ubcspin/CuddleBits/README.md

CuddleBits are simple robots designed to study affective touch. This repository contains instructions on how to build your own CuddleBits, as well as modify the starter templates provided. Two main kinds of CuddleBits are contained here: RibBits and FlexiBits.

Check out [www.cs.ubc.ca/labs/spin/cuddlebits](http://www.cs.ubc.ca/labs/spin/cuddlebits) for the project page.
