ubcspin/CuddleBits/ribbit/full.SLDASM

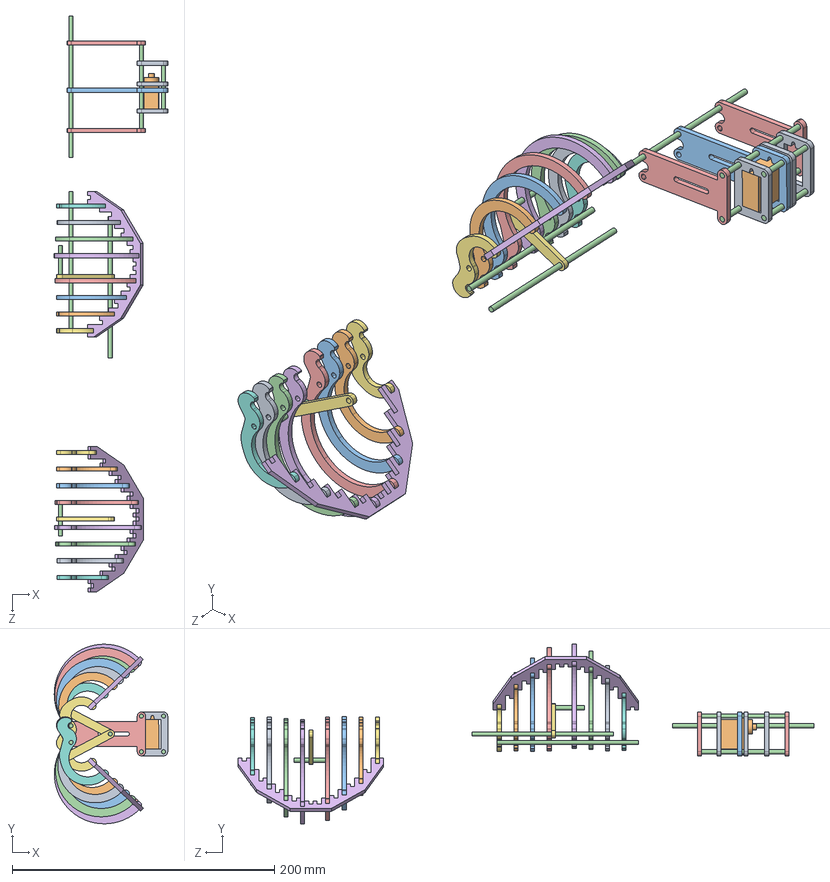
[picture p1: CAD file, 2016-09-14, last stored version]
ribbit/full.SLDASM
86.6 x 137.0 x 439.2 mm
servo_brackt x 3
servo
servo_strut_bracket
pin x 9
strut_support x 2
rib_holder x 2
rib00 x 2
rib01 x 2
rib03 x 2
rib02 x 2
rib04 x 2
rib05 x 2
rib06 x 2
rib07 x 2
bar x 2
