ubcspin/CuddleBits/ribbit/frame.SLDASM

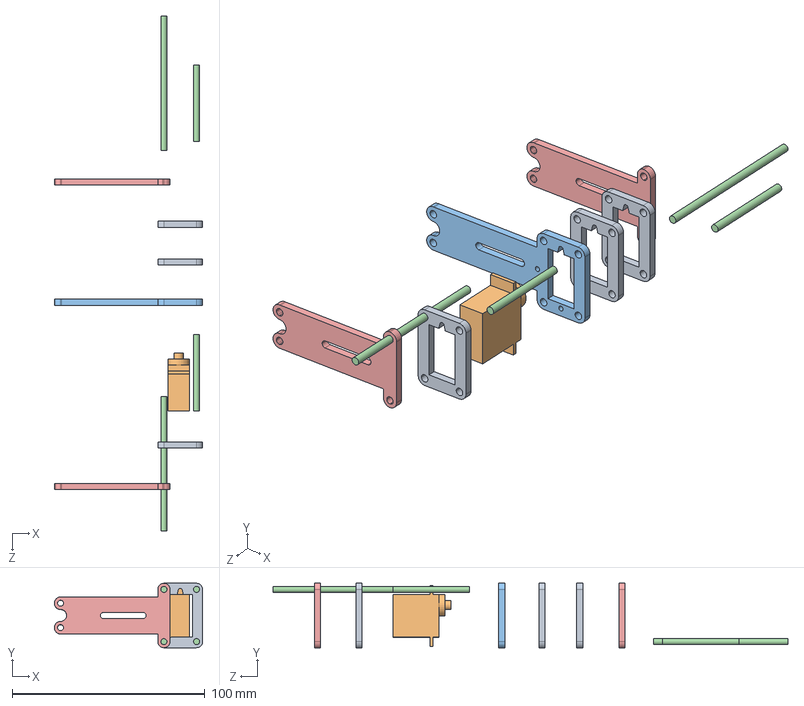
[picture p2: CAD file, 2016-09-14, last stored version]
ribbit/frame.SLDASM
77.0 x 33.5 x 267.4 mm
servo_brackt x 3
servo
servo_strut_bracket
pin x 4
strut_support x 2
