ubcspin/CuddleBits/ribbit/ribs.SLDASM

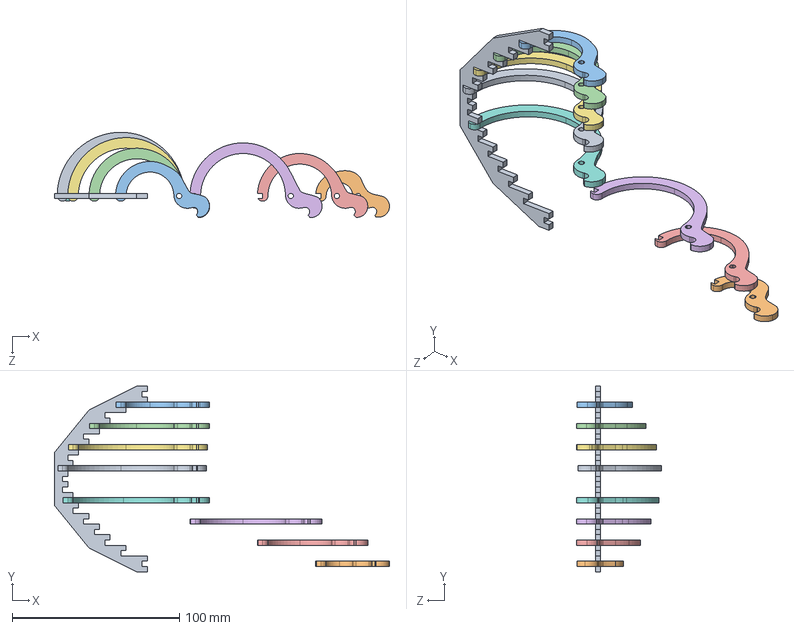
[picture p3: CAD file, 2016-09-14, last stored version]
ribbit/ribs.SLDASM
200.5 x 111.1 x 51.1 mm
rib_holder
rib00
rib01
rib03
rib02
rib04
rib05
rib06
rib07
