ubcspin/CuddleBits/ribbit/servo.SLDPRT

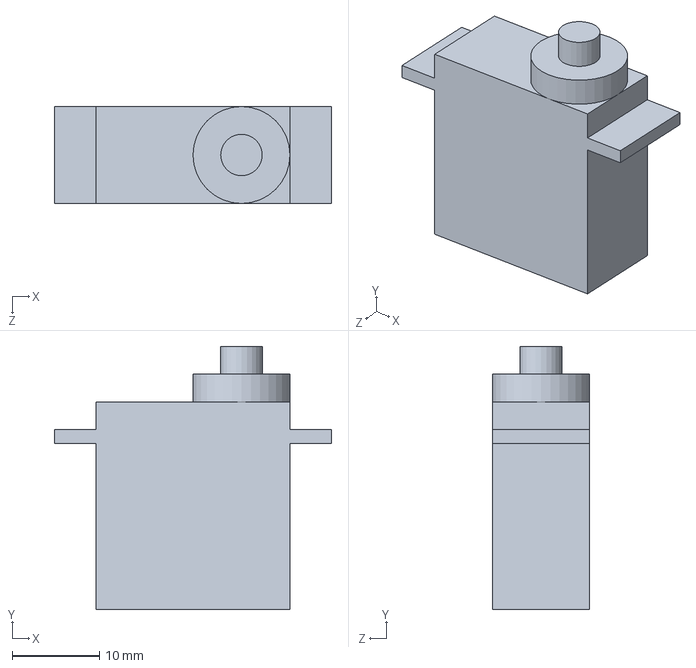
[picture p4: CAD file, 2016-09-14, last stored version]
ribbit/servo.SLDPRT
31.8 x 30.2 x 11.1 mm
