ubcspin/CuddleBits/ribbit/pin_end_flat.sldprt

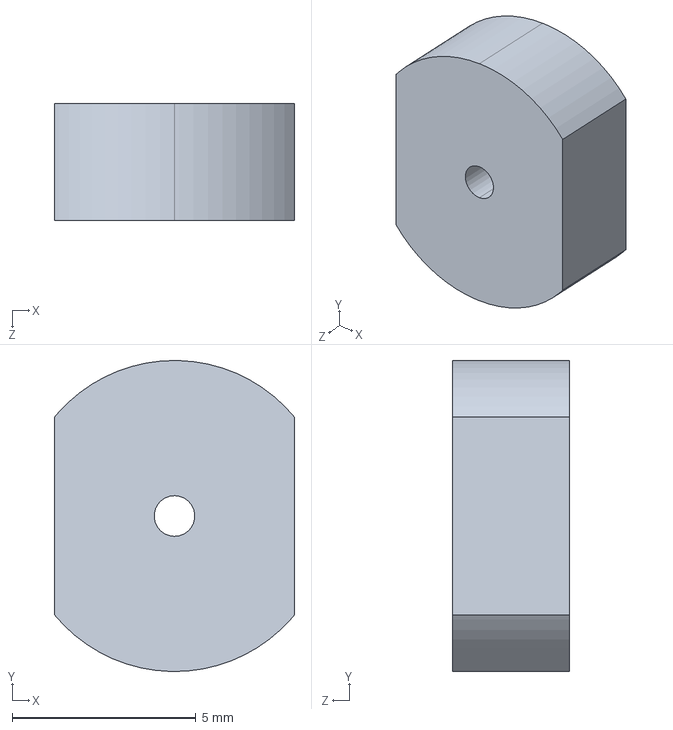
[picture p5: CAD file, 2016-09-14, last stored version]
ribbit/pin_end_flat.sldprt
6.54 x 8.47 x 3.17 mm
