ubcspin/CuddleBits/ribbit/rib07.sldprt

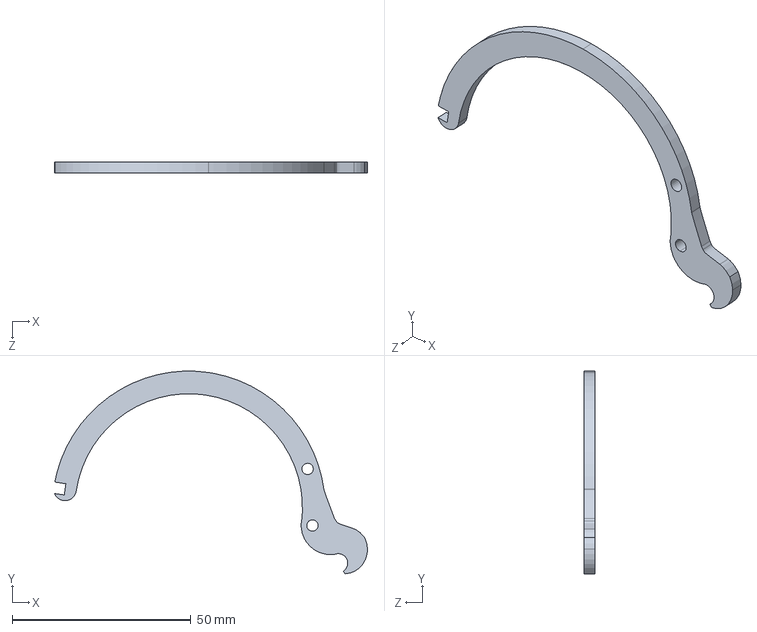
[picture p6: CAD file, 2016-09-14, last stored version]
ribbit/rib07.sldprt
87.4 x 56.6 x 3.17 mm
