ubcspin/CuddleBits/ribbit/rib08.sldprt

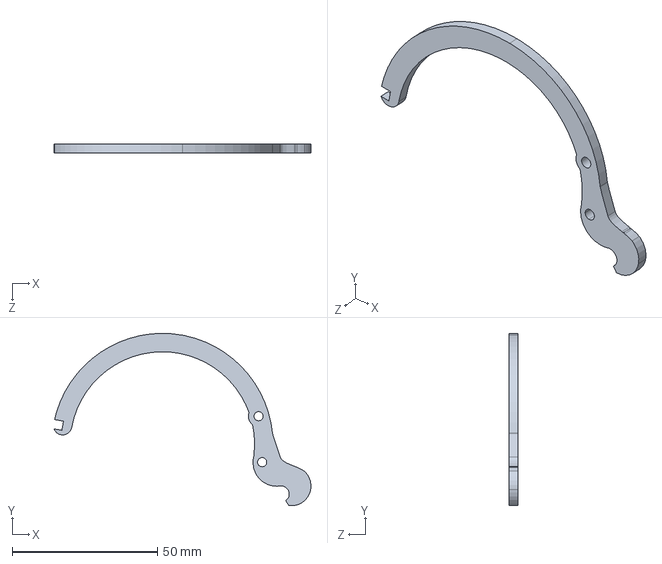
[picture p7: CAD file, 2016-09-14, last stored version]
ribbit/rib08.sldprt
88.5 x 59.3 x 3.17 mm
