ubcspin/CuddleBits/ribbit/rib02.sldprt

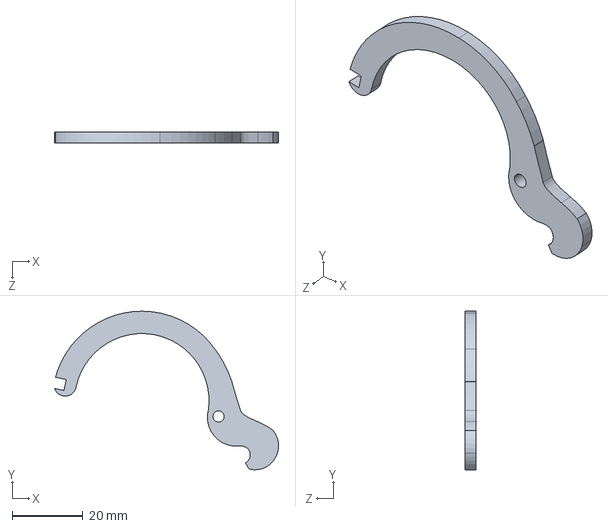
[picture p8: CAD file, 2016-09-14, last stored version]
ribbit/rib02.sldprt
63.5 x 45.0 x 3.17 mm
