ubcspin/CuddleBits/ribbit/strut_support.sldprt

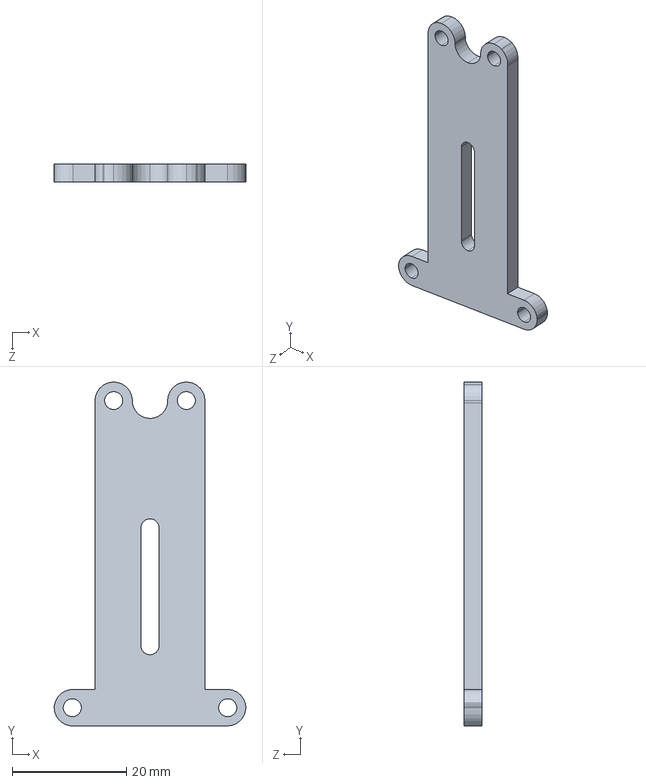
[picture p9: CAD file, 2016-09-14, last stored version]
ribbit/strut_support.sldprt
33.5 x 60.1 x 3.17 mm
