ubcspin/CuddleBits/ribbit/pin_end.sldprt

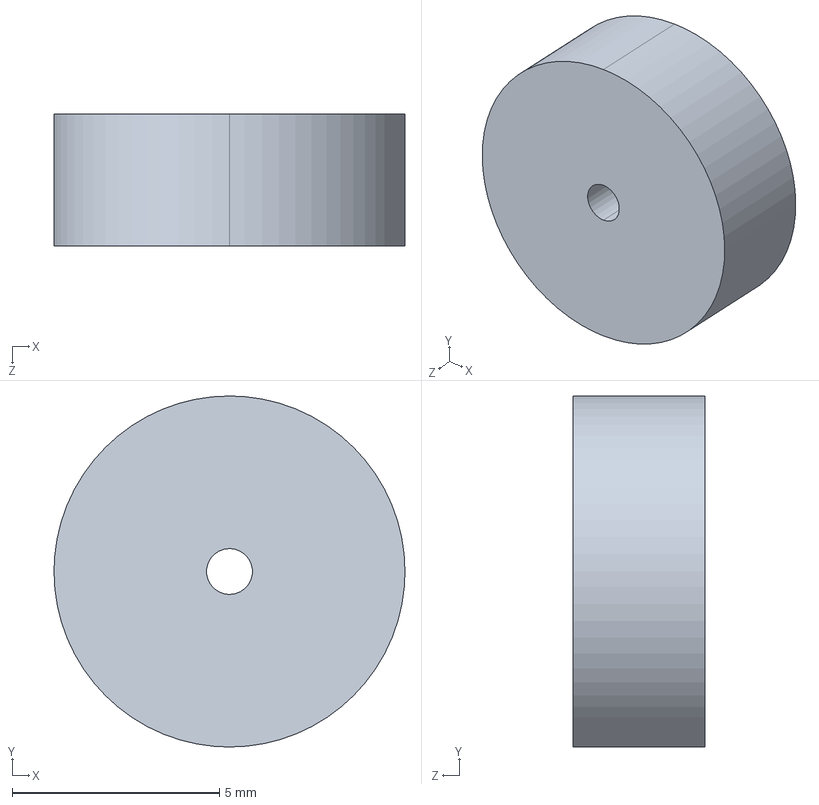
[picture p10: CAD file, 2016-09-14, last stored version]
ribbit/pin_end.sldprt
8.47 x 8.47 x 3.17 mm
