ubcspin/CuddleBits/ribbit/bar.sldprt

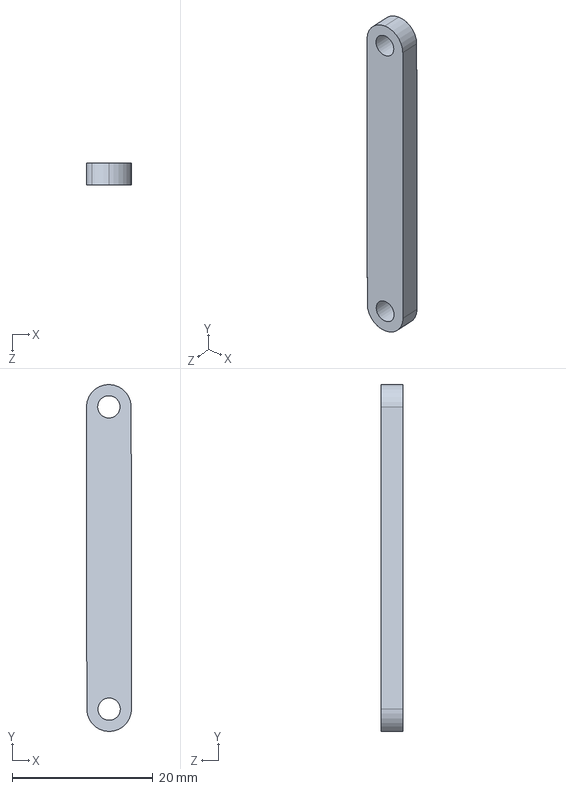
[picture p11: CAD file, 2016-09-14, last stored version]
ribbit/bar.sldprt
6.40 x 49.3 x 3.17 mm
