ubcspin/CuddleBits/ribbit/rib06.sldprt

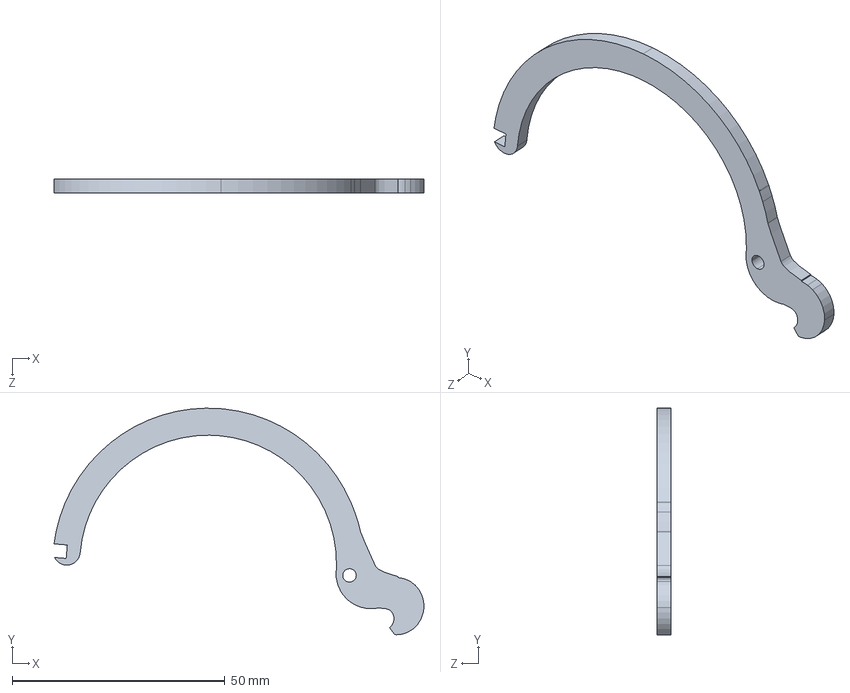
[picture p12: CAD file, 2016-09-14, last stored version]
ribbit/rib06.sldprt
86.9 x 53.3 x 3.17 mm
