ubcspin/CuddleBits/ribbit/rib_holder.sldprt

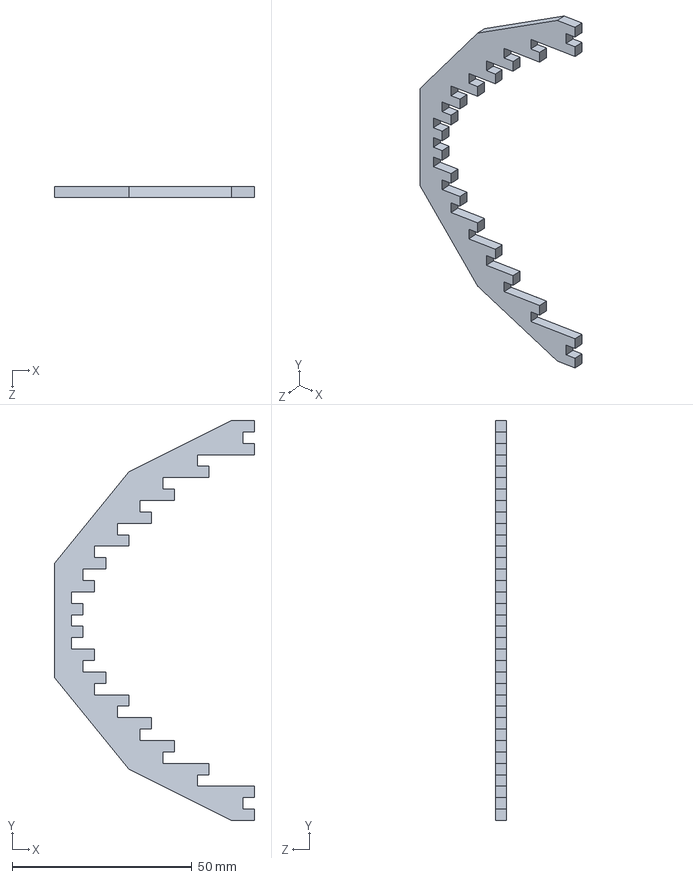
[picture p13: CAD file, 2016-09-14, last stored version]
ribbit/rib_holder.sldprt
55.6 x 111.1 x 3.17 mm
