ubcspin/CuddleBits/ribbit/servo_strut_bracket.sldprt

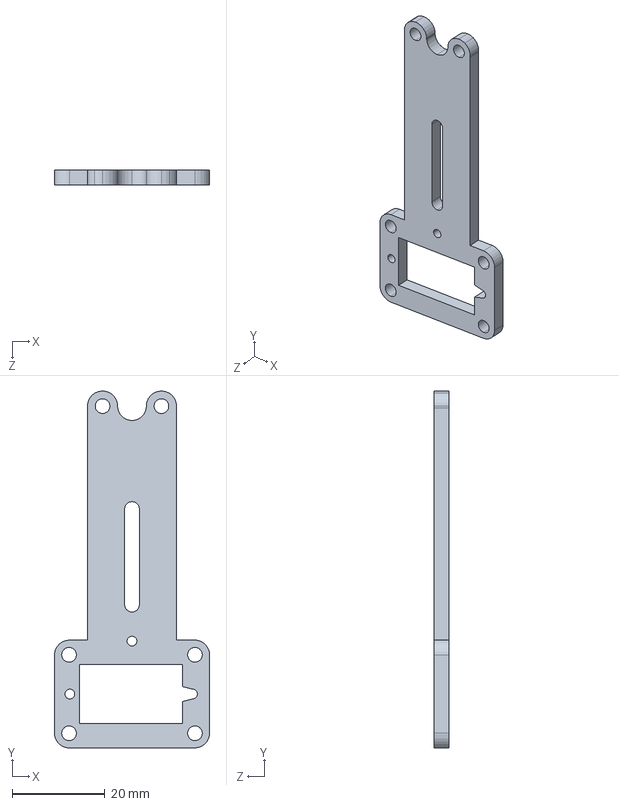
[picture p14: CAD file, 2016-09-14, last stored version]
ribbit/servo_strut_bracket.sldprt
33.5 x 77.0 x 3.17 mm
