ubcspin/CuddleBits/ribbit/rib05.sldprt

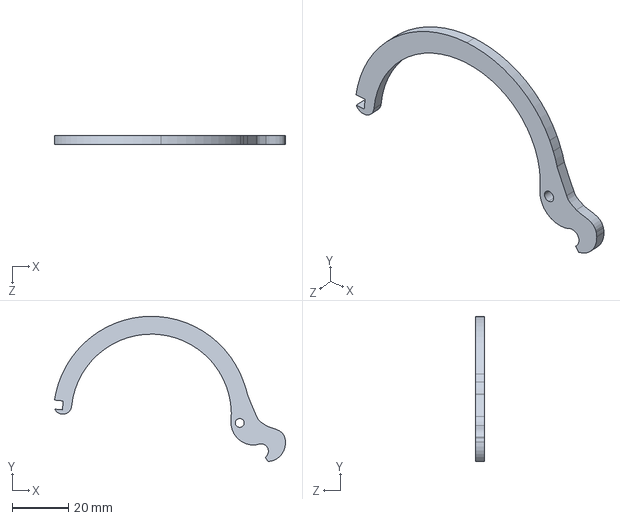
[picture p15: CAD file, 2016-09-14, last stored version]
ribbit/rib05.sldprt
82.5 x 51.9 x 3.17 mm
