ubcspin/CuddleBits/ribbit/rib01.sldprt

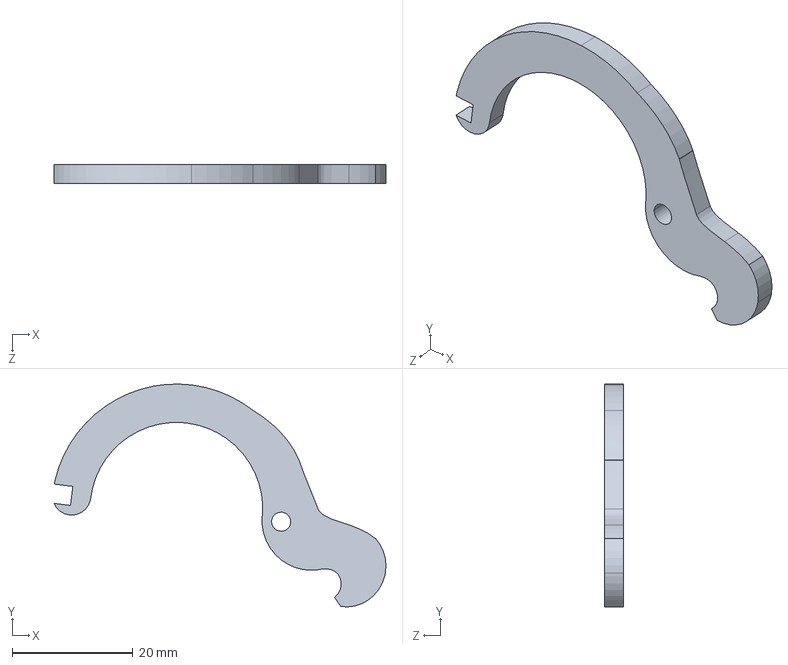
[picture p16: CAD file, 2016-09-14, last stored version]
ribbit/rib01.sldprt
54.9 x 36.9 x 3.17 mm
