ubcspin/CuddleBits/ribbit/pin.SLDPRT

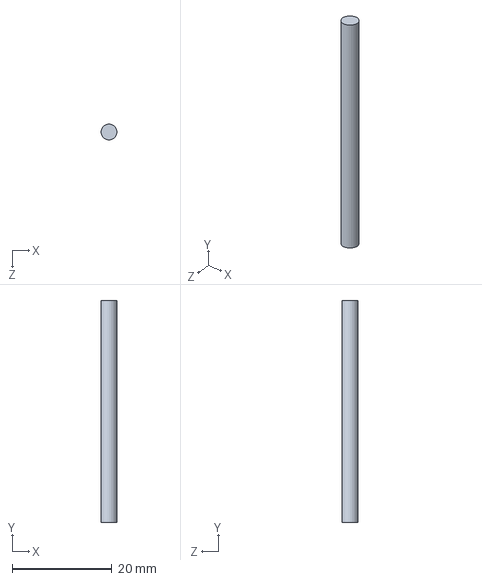
[picture p17: CAD file, 2016-09-14, last stored version]
ribbit/pin.SLDPRT
3.17 x 44.5 x 3.17 mm
