ubcspin/CuddleBits/ribbit/rib04.sldprt

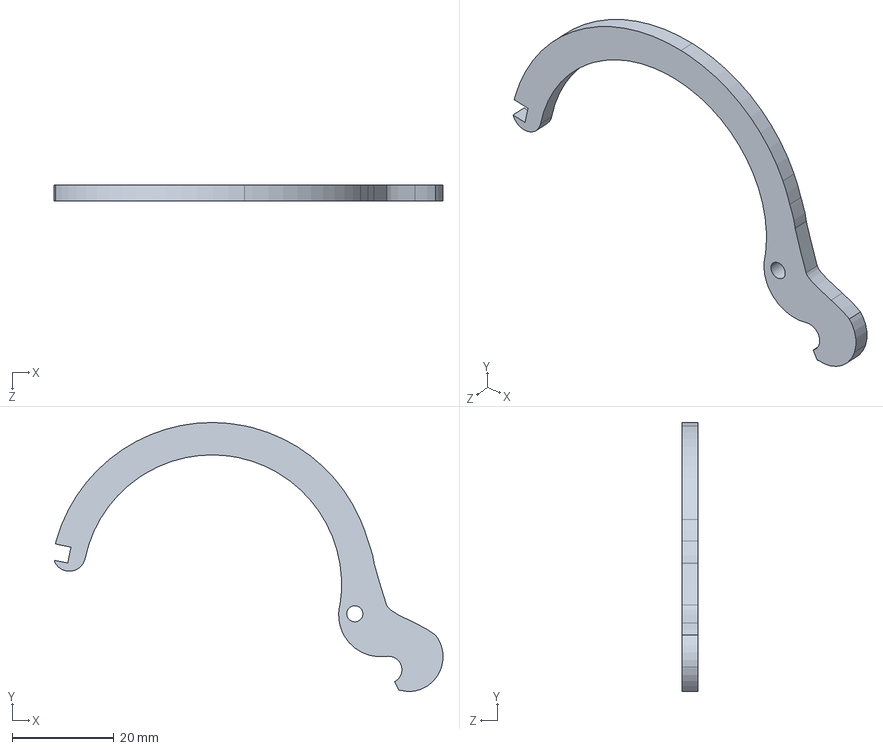
[picture p18: CAD file, 2016-09-14, last stored version]
ribbit/rib04.sldprt
76.3 x 52.8 x 3.17 mm
