ubcspin/CuddleBits/ribbit/orig_from_ai.dxf

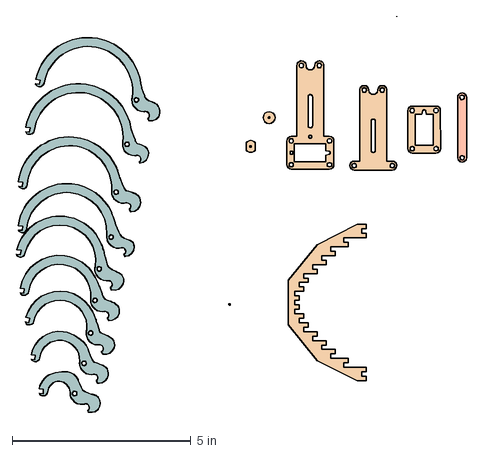
[picture p19: CAD file, 2016-09-14, last stored version]
ribbit/orig_from_ai.dxf
12.6 x 11.1 in
