ubcspin/CuddleBits/ribbit/servo_brackt.sldprt

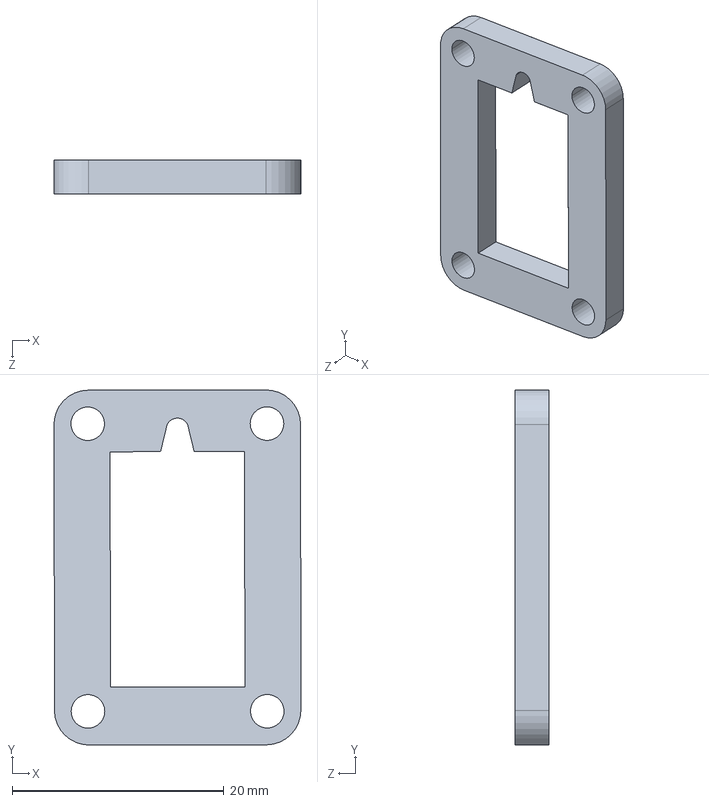
[picture p20: CAD file, 2016-09-14, last stored version]
ribbit/servo_brackt.sldprt
23.3 x 33.5 x 3.17 mm
