ubcspin/CuddleBits/ribbit/rib00.sldprt

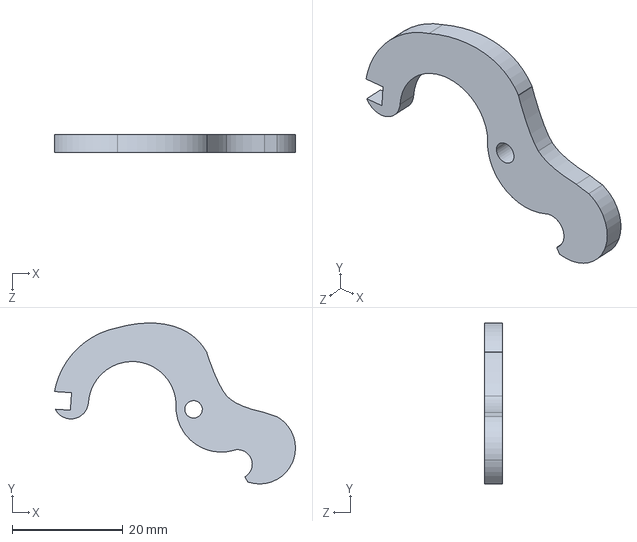
[picture p21: CAD file, 2016-09-14, last stored version]
ribbit/rib00.sldprt
43.6 x 29.1 x 3.17 mm
