ubcspin/CuddleBits/ribbit/rib03.sldprt

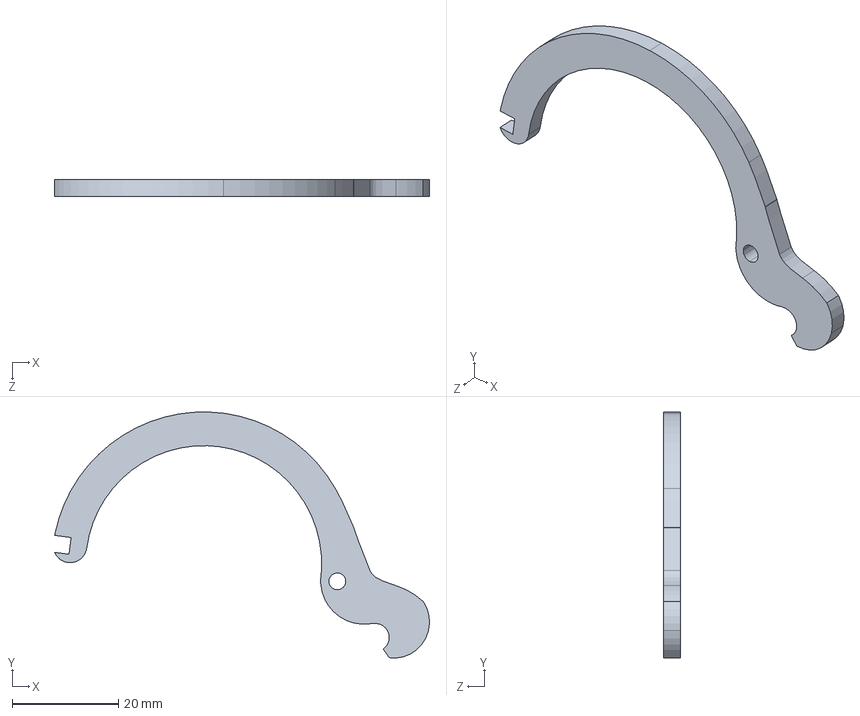
[picture p22: CAD file, 2016-09-14, last stored version]
ribbit/rib03.sldprt
70.7 x 46.3 x 3.17 mm
