ubcspin/CuddleBits/(list of files, cad)

Other CAD files:
ribbit/orig_import_.SLDPRT
ribbit/Draw3.SLDDRW
ribbit/frame-exp.SLDDRW
ribbit/frame.SLDDRW
ribbit/full-only.SLDDRW
ribbit/full.DWG
ribbit/full.SLDDRW
