ubcspin/CuddleBits/flexibit/assembly_instructions.pdf

1x

2x

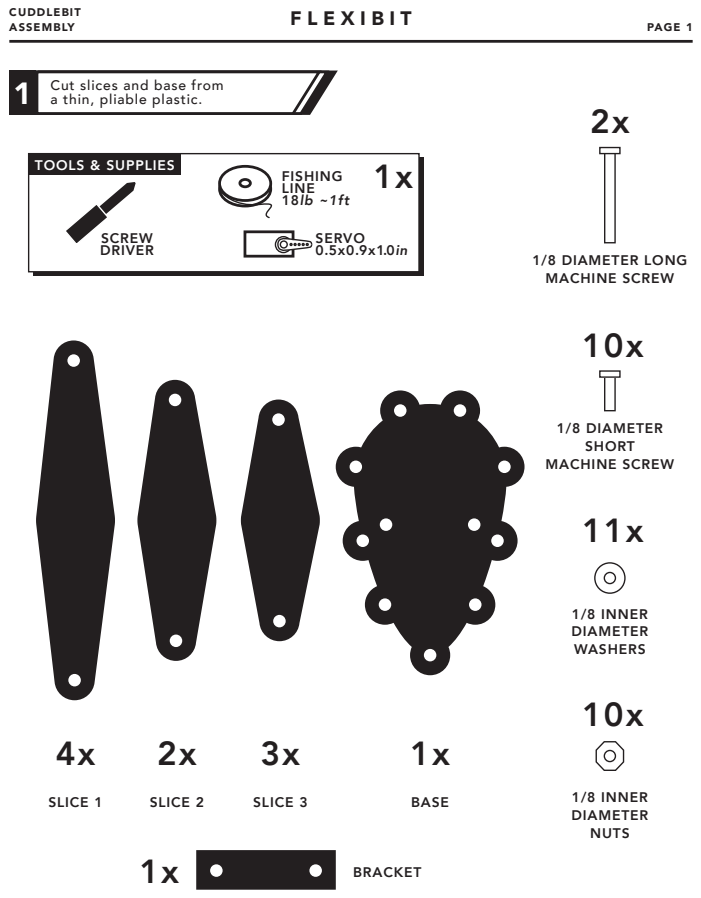
[picture p23: page 1]
CUDDLEBIT; ASSEMBLY; PAGE 1 FLEXIBIT; SLICE 1; SLICE 2; SLICE 3; BASE; SCREW DRIVER; TOOLS & SUPPLIES; SERVO 0.5x0.9x1.0in; FISHING LINE 18lb ~1ft; 1/8 DIAMETER SHORT MACHINE SCREW; 1/8 DIAMETER LONG MACHINE SCREW; 1/8 INNER DIAMETER WASHERS 10x; 1/8 INNER DIAMETER NUTS; BRACKET

1 Cut slices and base from
a thin, pliable plastic.

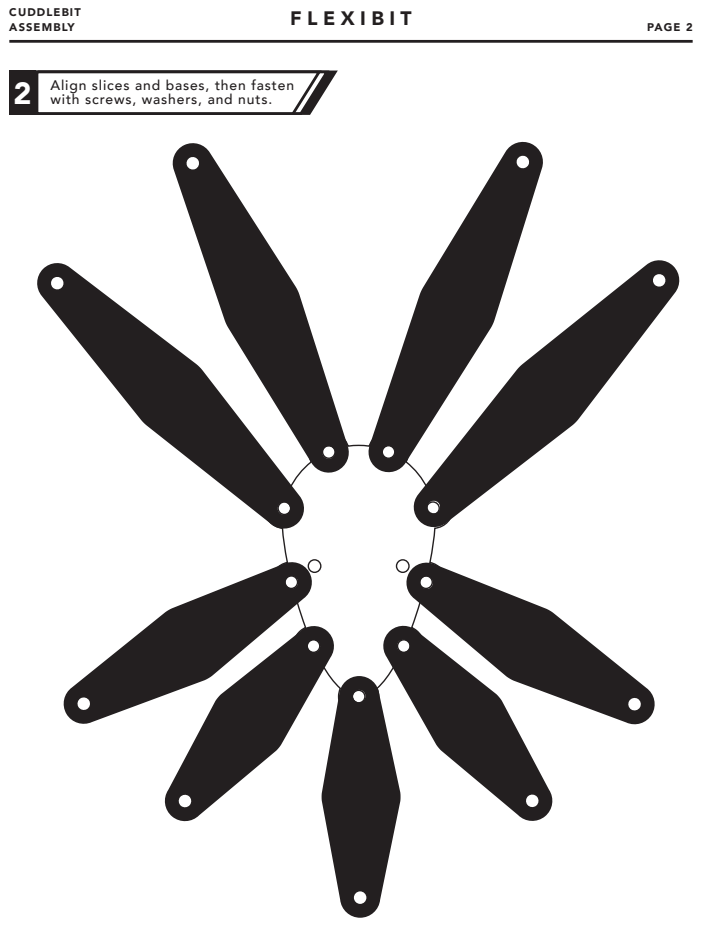
[picture p24: page 2]
CUDDLEBIT; ASSEMBLY; PAGE 2 FLEXIBIT

2 Align slices and bases, then fasten
with screws, washers, and nuts.

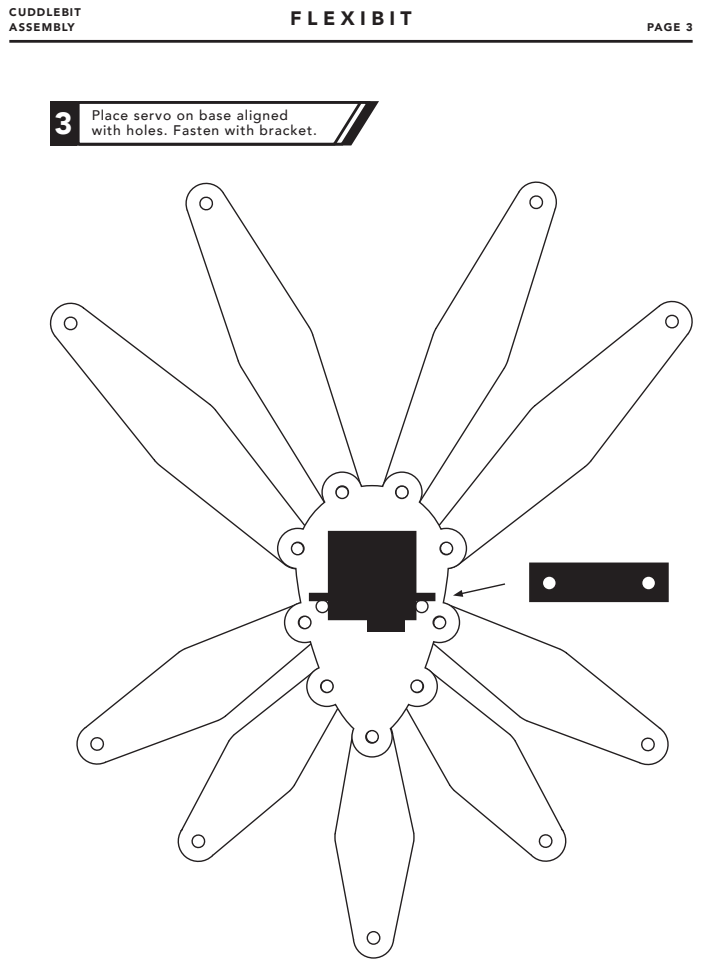
[picture p25: page 3]
CUDDLEBIT; ASSEMBLY; PAGE 3 FLEXIBIT

3 Place servo on base aligned
with holes. Fasten with bracket.

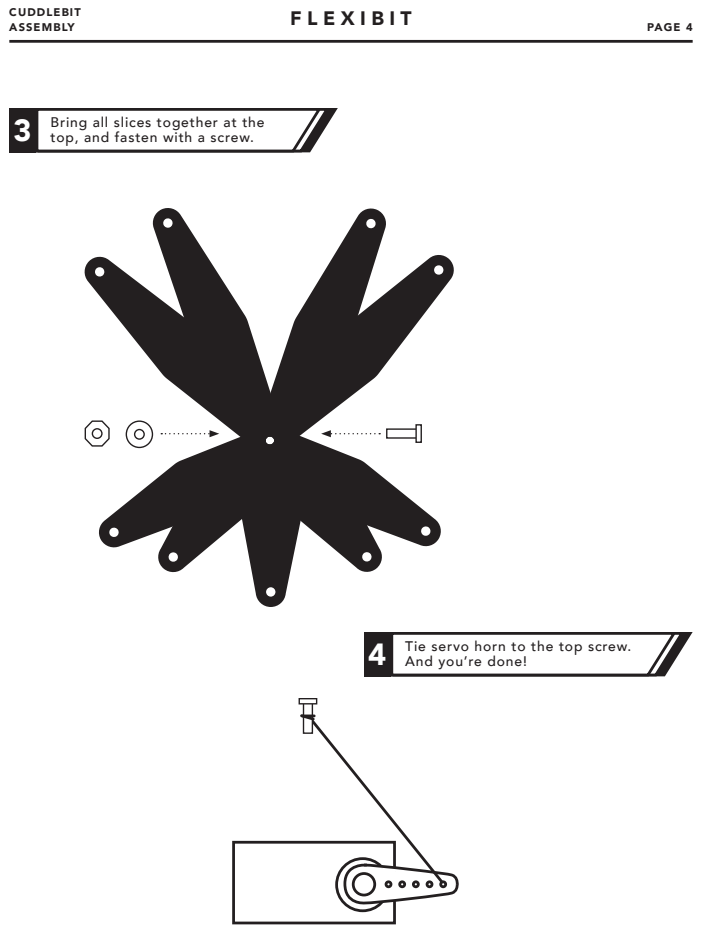
[picture p26: page 4]
CUDDLEBIT; ASSEMBLY; PAGE 4 FLEXIBIT

3 Bring all slices together at the
top, and fasten with a screw.

4 Tie servo horn to the top screw.
And you’re done!
