ubcspin/CuddleBits/ribbit/assembly_instructions.pdf

1x

2x

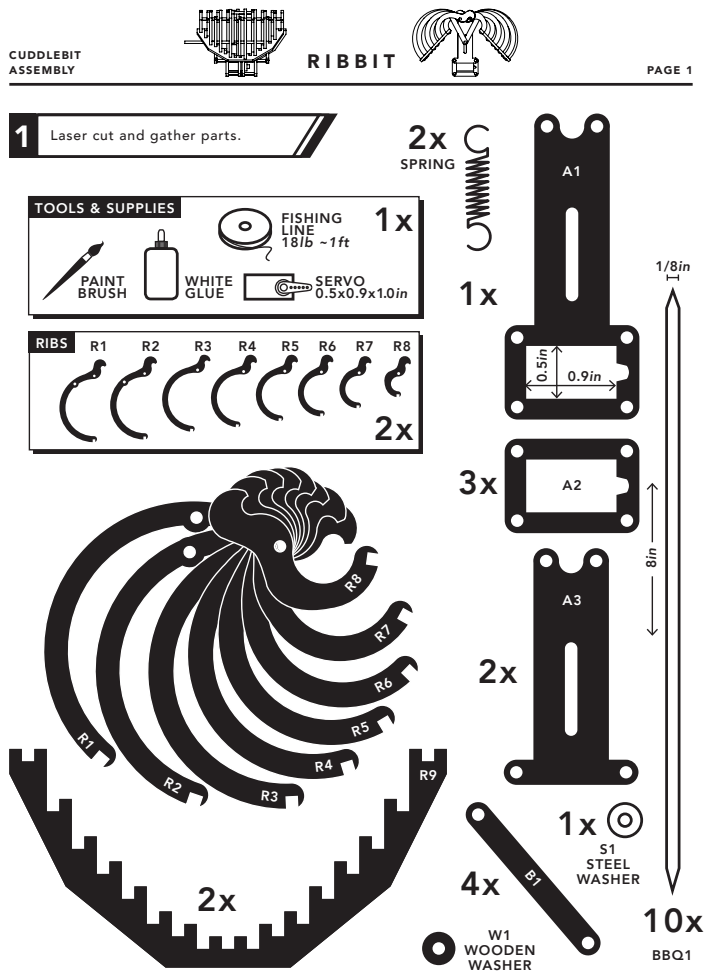
[picture p27: page 1]

1 Laser cut and gather parts.

2x

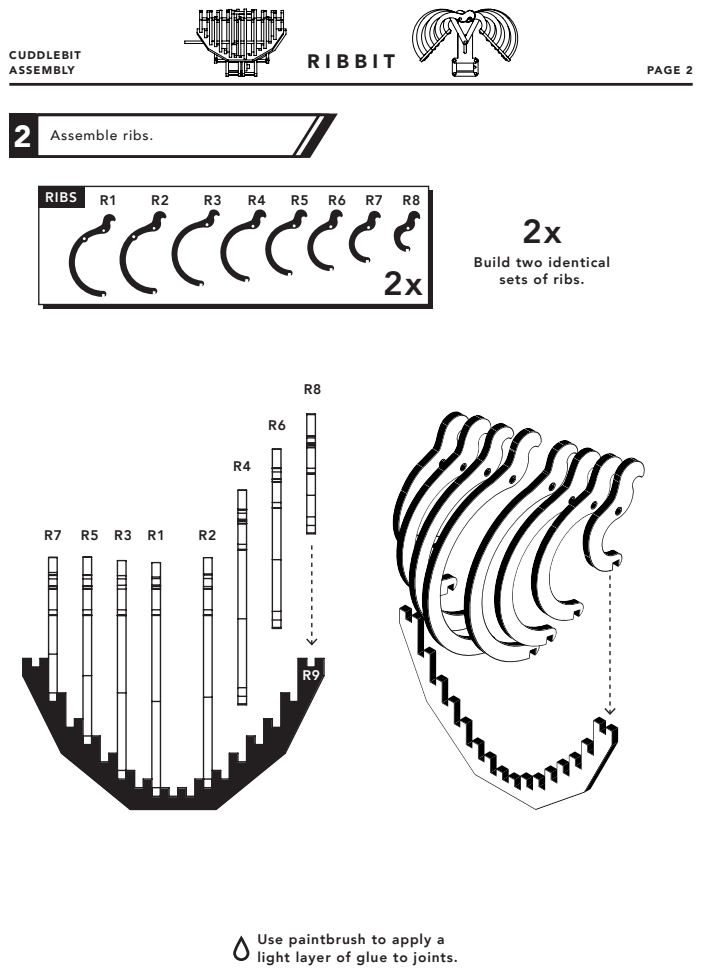
[picture p28: page 2]

Use paintbrush to apply a
light layer of glue to joints.

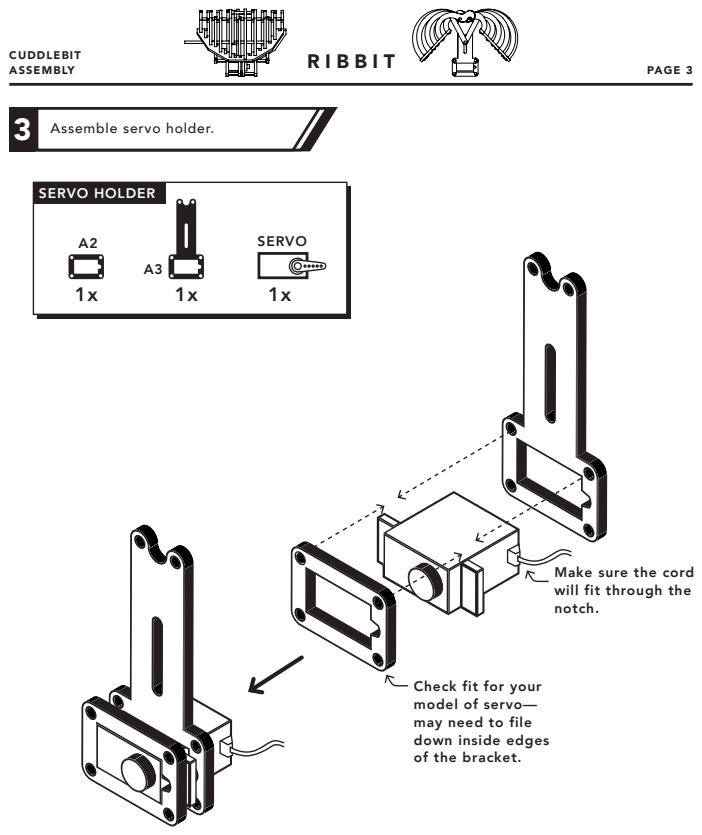
[picture p29: page 3]
CUDDLEBIT; ASSEMBLY; RIBBIT; PAGE 3; SERVO HOLDER; SERVO

3 Assemble servo holder.

Make sure the cord
will fit through the
notch.

Check fit for your
model of servo—
may need to file
down inside edges
of the bracket.

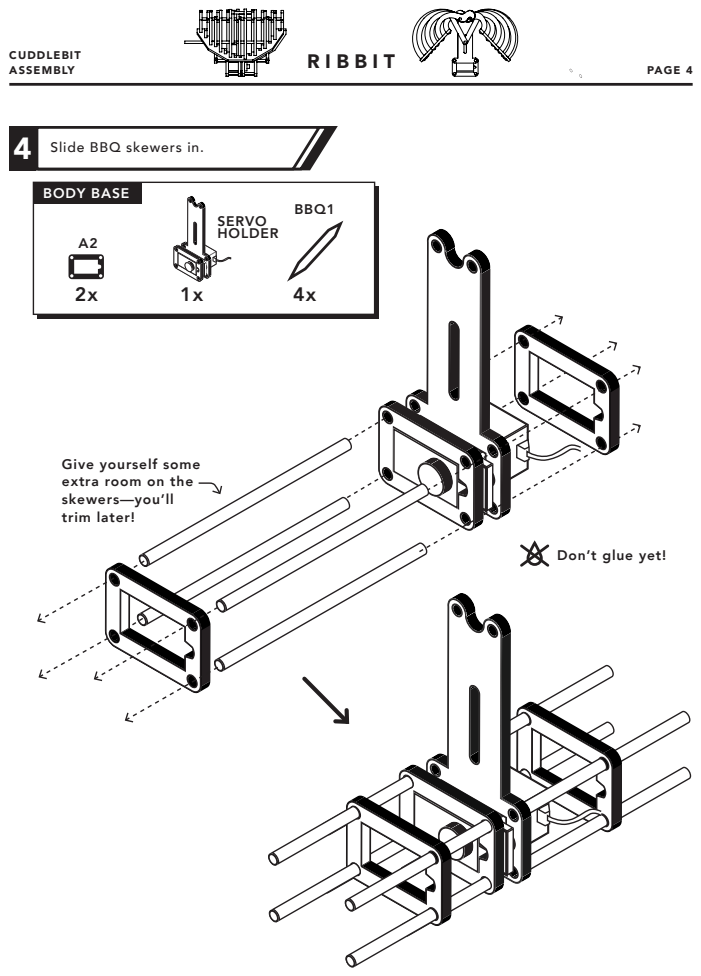
[picture p30: page 4]
CUDDLEBIT; ASSEMBLY; RIBBIT; PAGE 4; BODY BASE; SERVO HOLDER; BBQ1

4 Slide BBQ skewers in.

Give yourself some
extra room on the
skewers—you’ll
trim later!

Don’t glue yet!

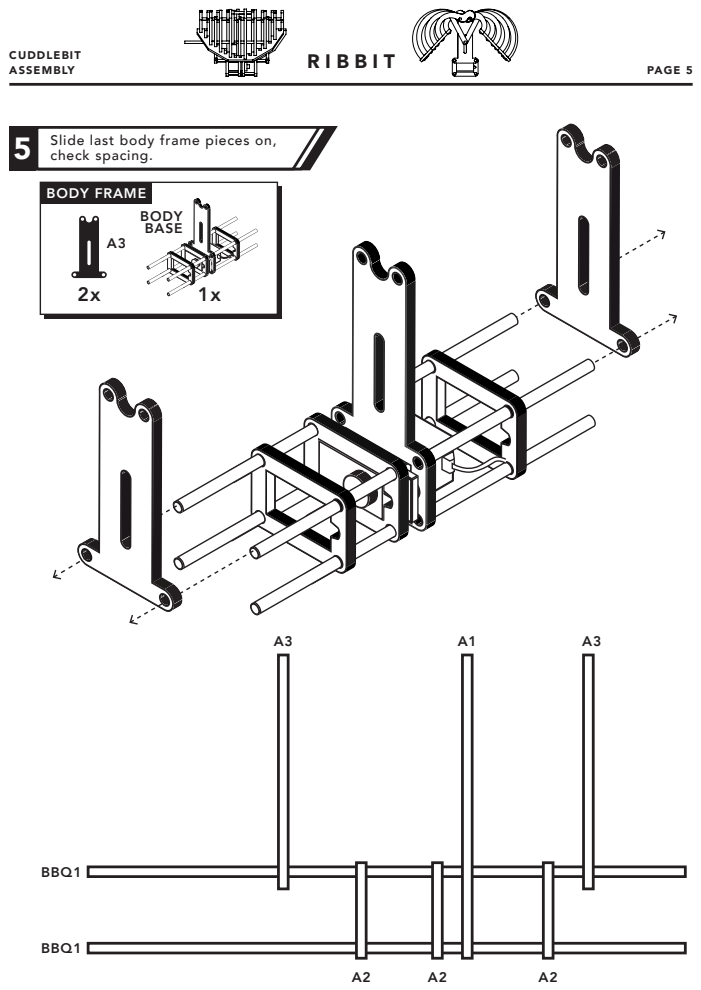
[picture p31: page 5]
CUDDLEBIT; ASSEMBLY; RIBBIT; PAGE 5; BODY BASE; BBQ1

5 Slide last body frame pieces on,
check spacing.
BODY FRAME

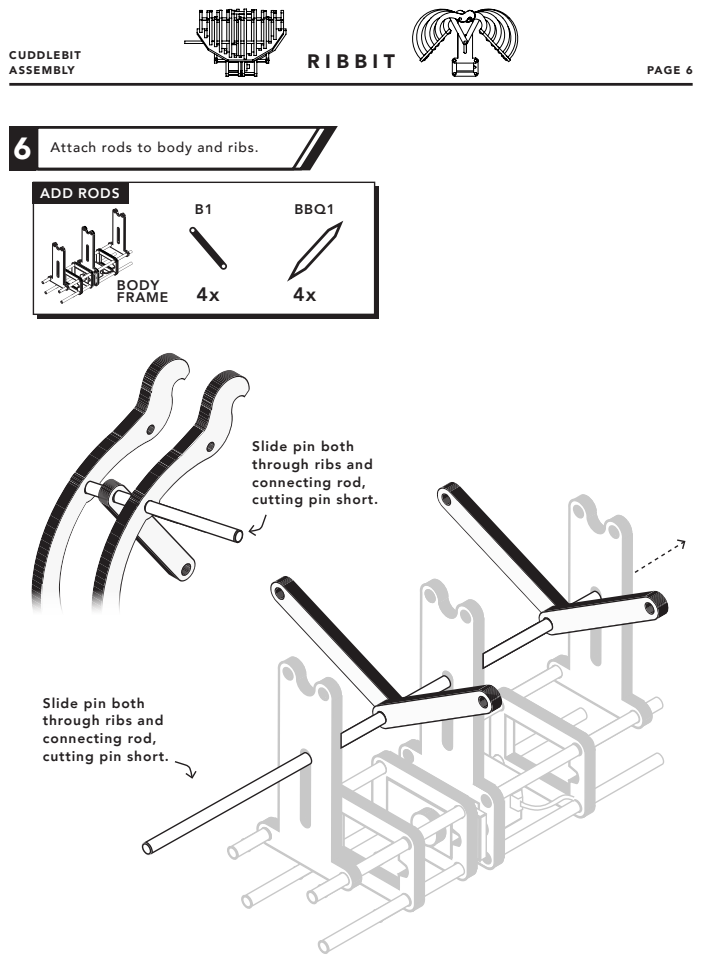
[picture p32: page 6]
CUDDLEBIT; ASSEMBLY; RIBBIT; PAGE 6; ADD RODS; BBQ1; BODY FRAME

6 Attach rods to body and ribs.

Slide pin both
through ribs and
connecting rod,
cutting pin short.

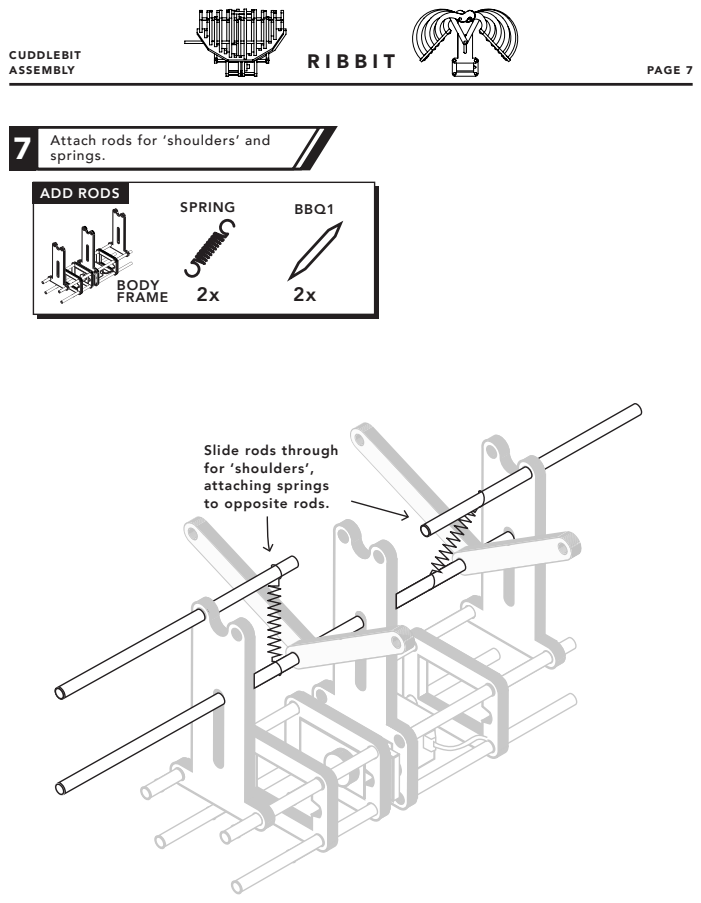
[picture p33: page 7]
CUDDLEBIT; ASSEMBLY; RIBBIT; PAGE 7; SPRING; BBQ1; BODY FRAME

7 Attach rods for ‘shoulders’ and
springs.
ADD RODS

Slide rods through
for ‘shoulders’,
attaching springs
to opposite rods.

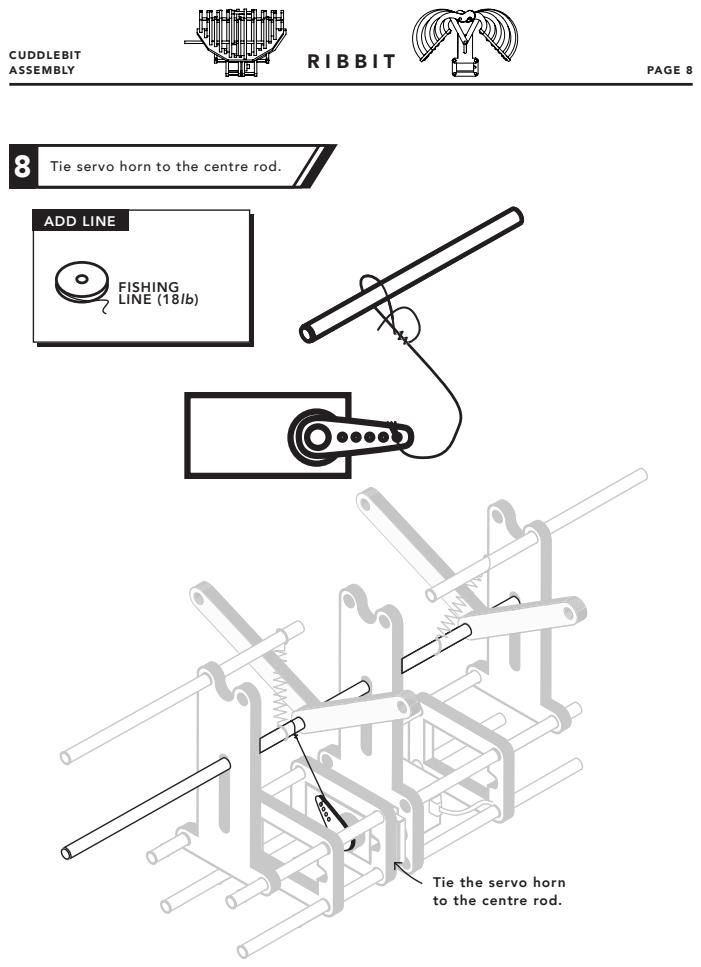
[picture p34: page 8]
CUDDLEBIT; ASSEMBLY; RIBBIT; PAGE 8; ADD LINE; FISHING LINE (18lb)

8 Tie servo horn to the centre rod.

Tie the servo horn
to the centre rod.

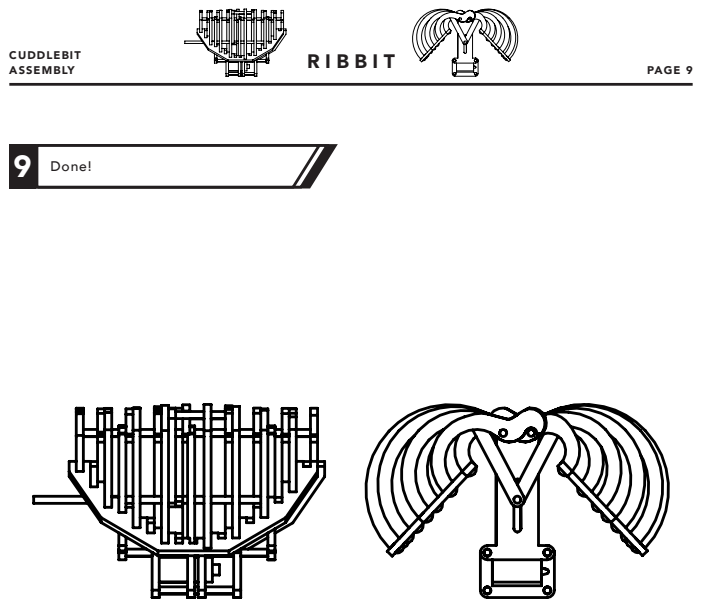
[picture p35: page 9]
CUDDLEBIT; ASSEMBLY; RIBBIT; PAGE 9 9; Done!
