ubcspin/CuddleBits/flexibit/how_to_make_flexibit.pdf

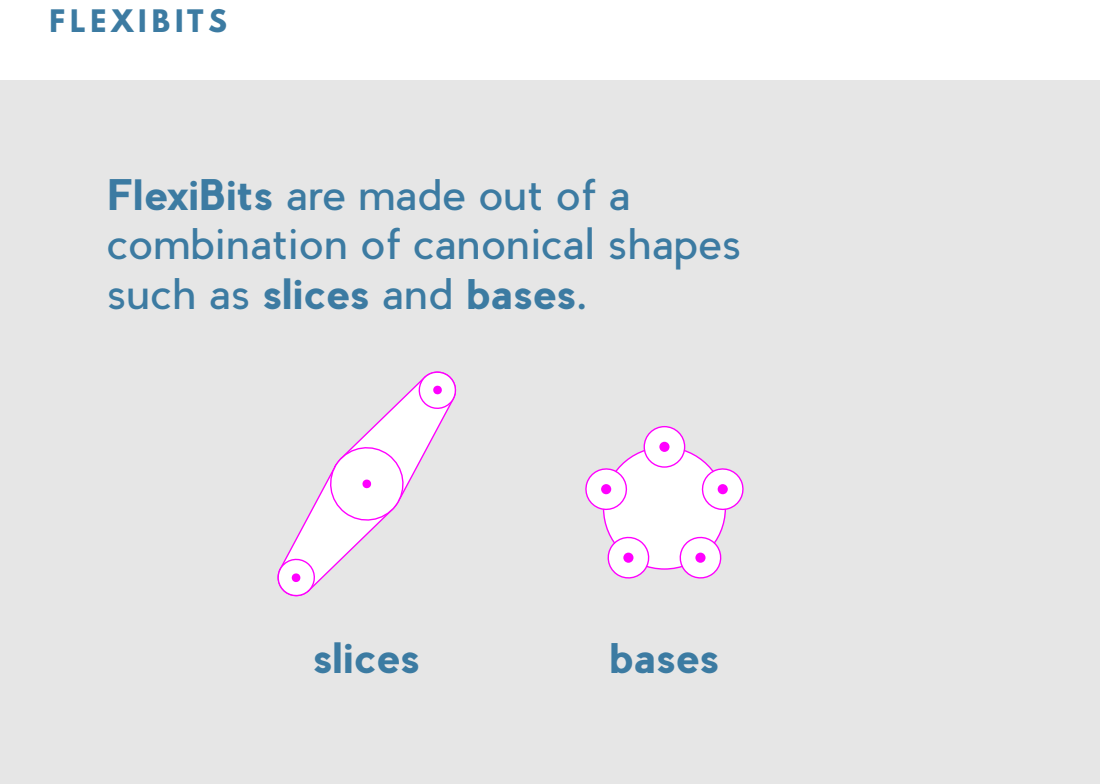
[picture p36: page 1]
FLEXIBITS; slices; bases

FlexiBits are made out of a
combination of canonical shapes
such as slices and bases.

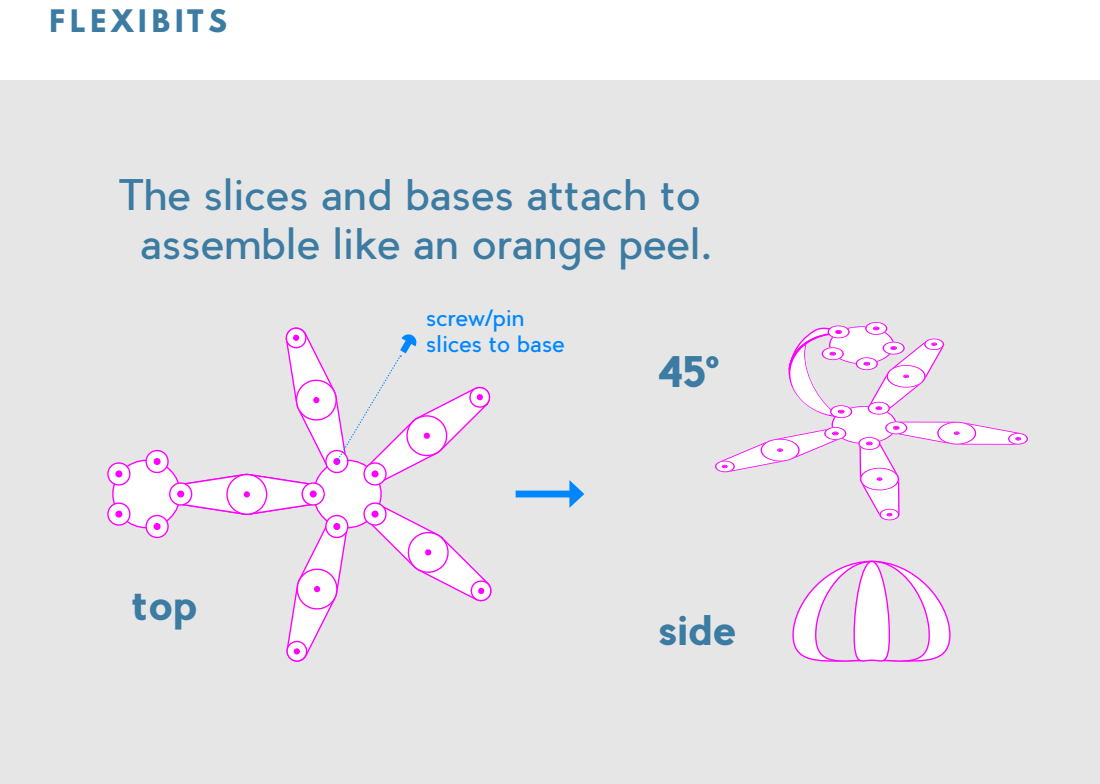
[picture p37: page 2]
FLEXIBITS; side; top

The slices and bases attach to
assemble like an orange peel.

screw/pin
slices to base

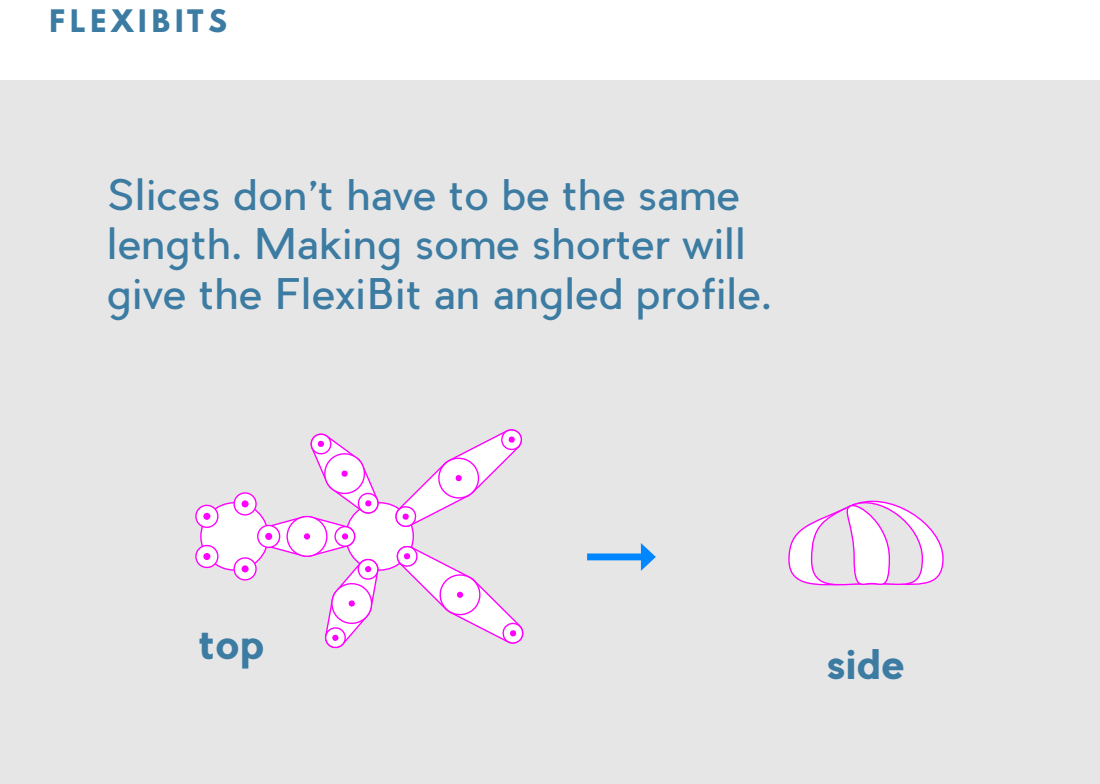
[picture p38: page 3]
FLEXIBITS; top; side

Slices don’t have to be the same
length. Making some shorter will
give the FlexiBit an angled profile.

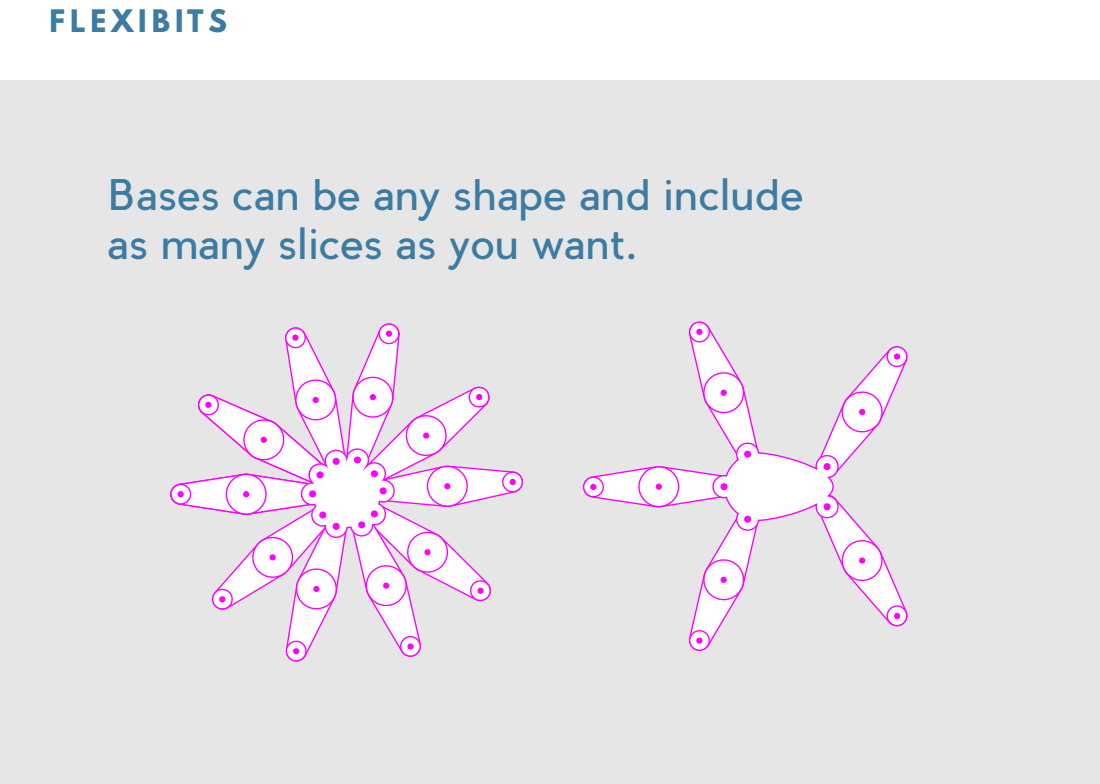
[picture p39: page 4]
FLEXIBITS

Bases can be any shape and include
as many slices as you want.

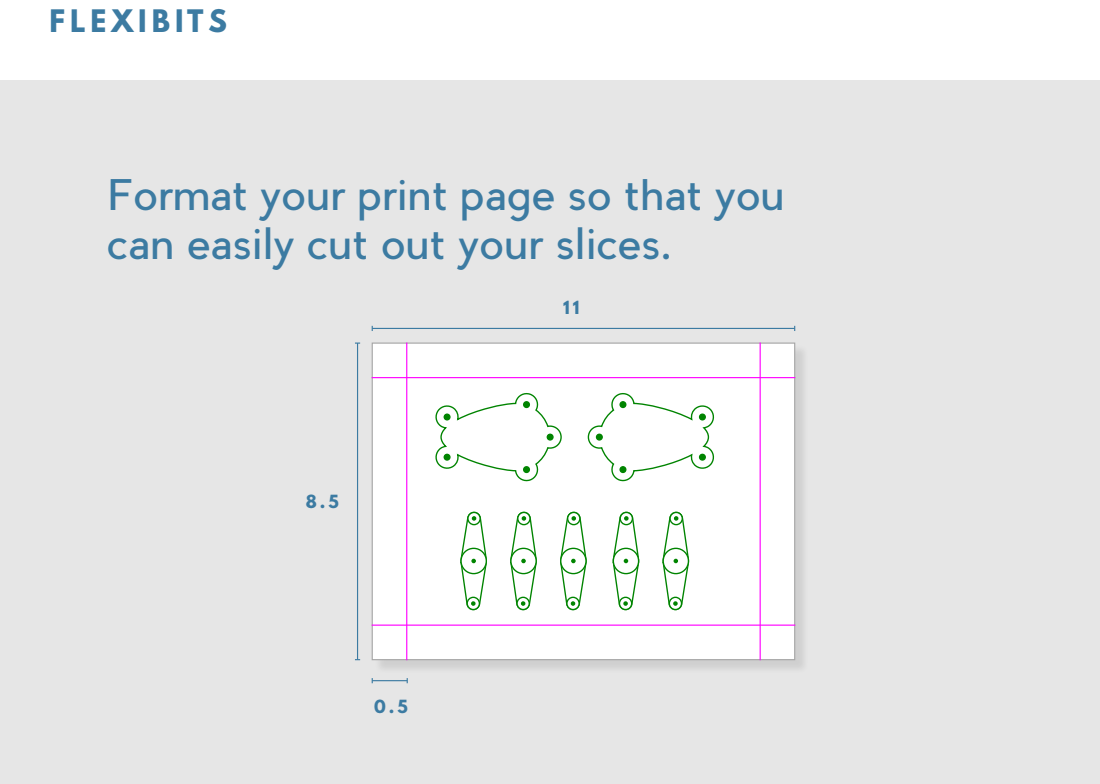
[picture p40: page 5]
FLEXIBITS

Format your print page so that you
can easily cut out your slices.
