ubcspin/CuddleBits/ribbit/how_to_make_ribbit.pdf

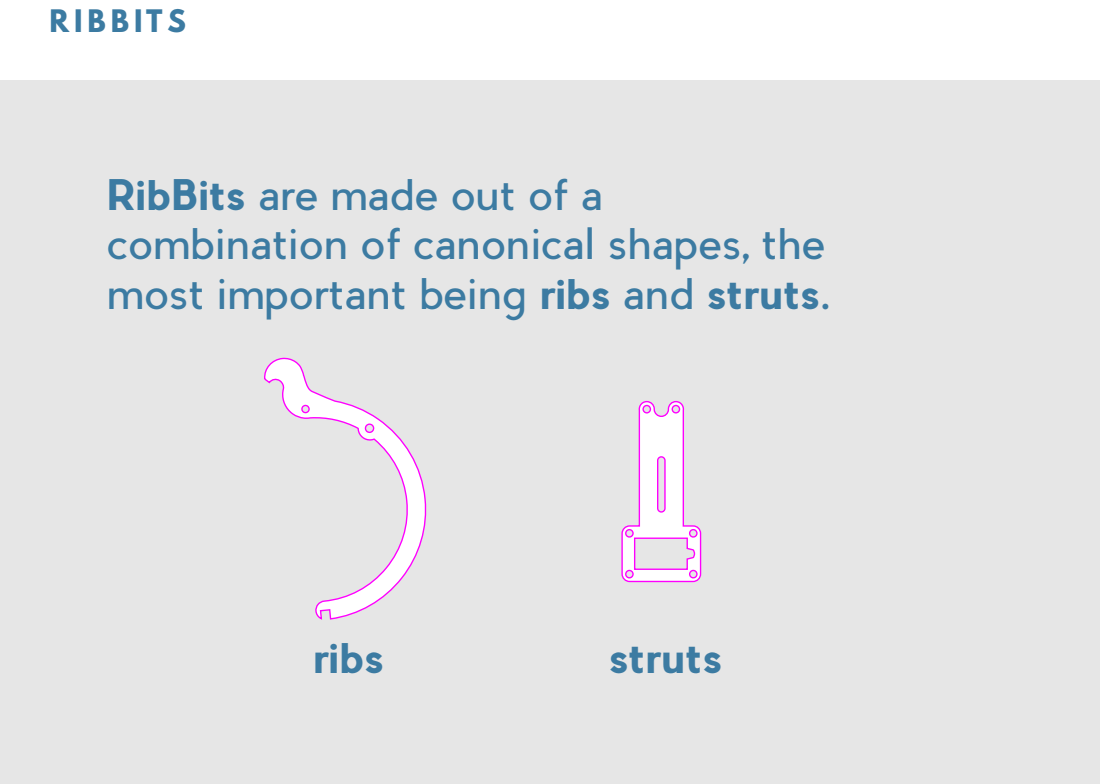
[picture p41: page 1]
RIBBITS; ribs; struts

RibBits are made out of a
combination of canonical shapes, the
most important being ribs and struts.

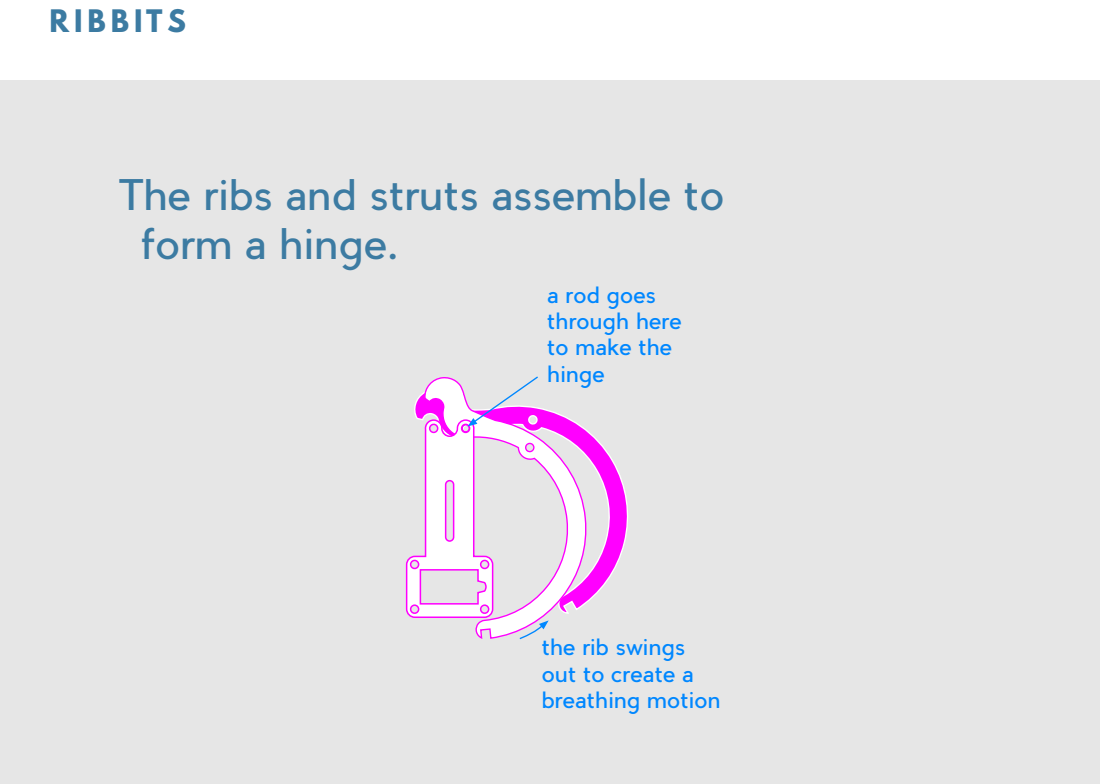
[picture p42: page 2]
RIBBITS

The ribs and struts assemble to
form a hinge.

a rod goes
through here
to make the
hinge

the rib swings
out to create a
breathing motion

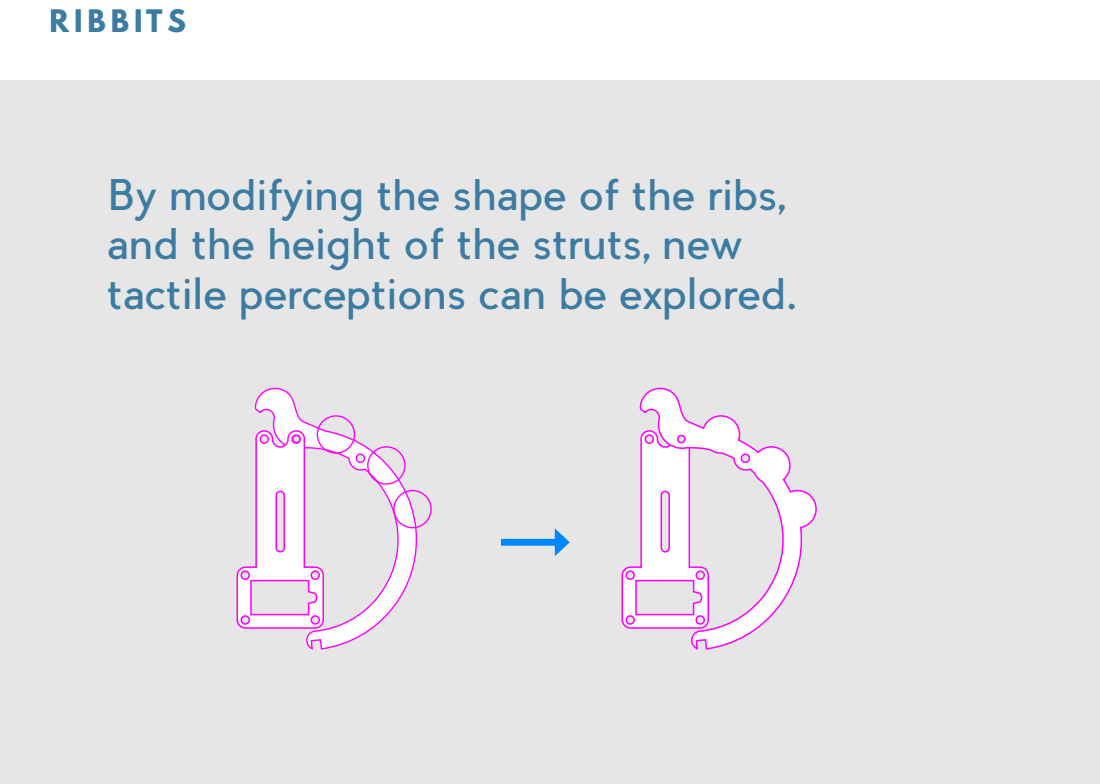
[picture p43: page 3]
RIBBITS

By modifying the shape of the ribs,
and the height of the struts, new
tactile perceptions can be explored.
