ubcspin/CuddleBits/flexibit/flexibit_cut_me_out.pdf

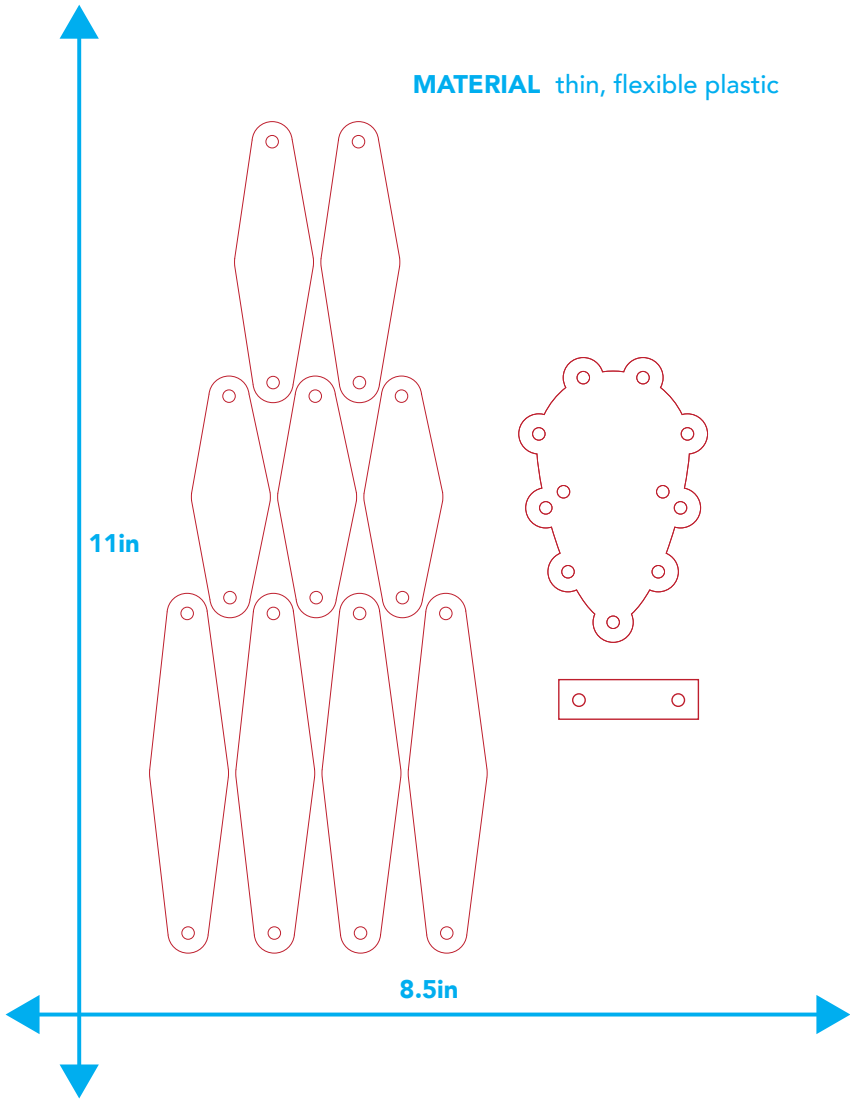
[picture p44: page 1]

MATERIAL thin, flexible plastic
