ubcspin/CuddleBits/ribbit/ribbit_lasercut_me.pdf

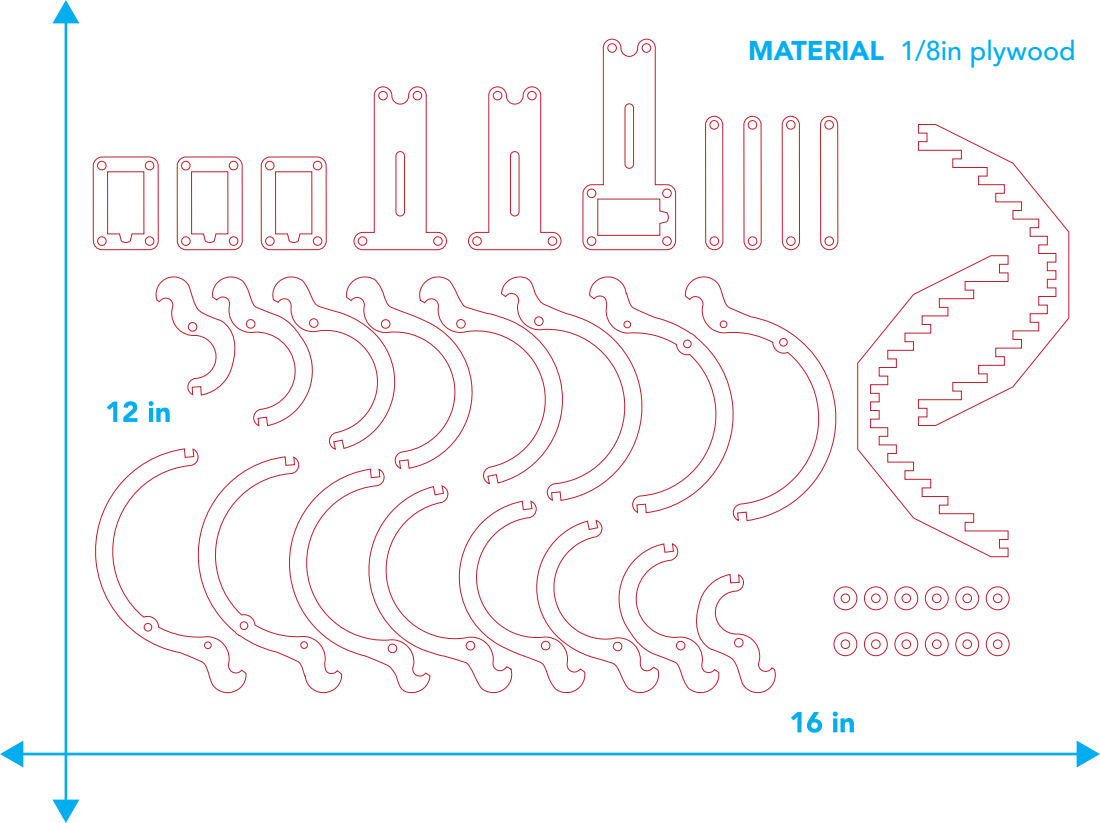
[picture p45: page 1]
MATERIAL 1/8in plywood
